kreier/solarmeter/aisvn/data/2020-05-26_battery_week.jpg

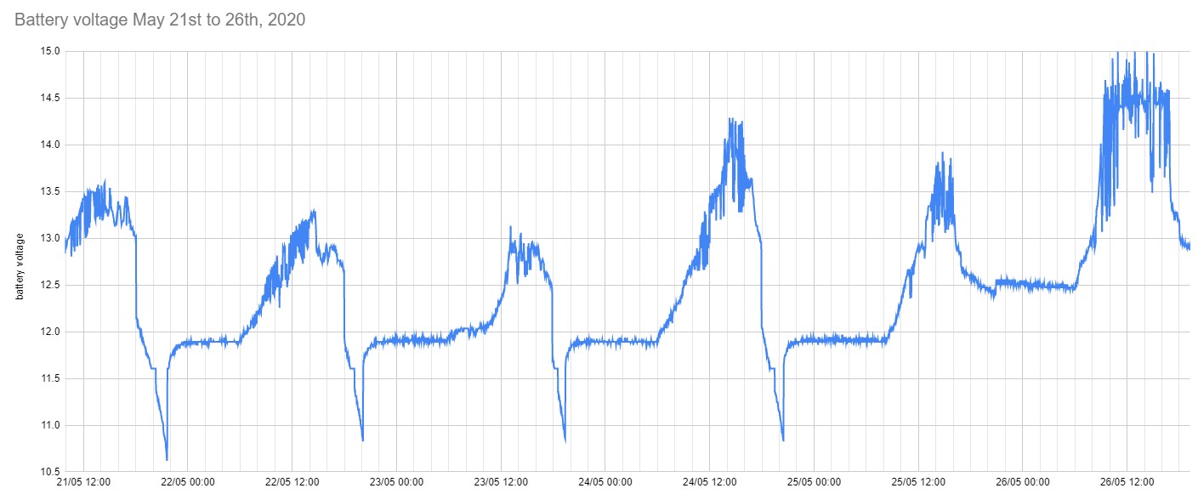
aisvn/data/2020-05-26_battery_week.jpg
