kreier/solarmeter/pic/2020-06-03_sketch_circuit.jpg

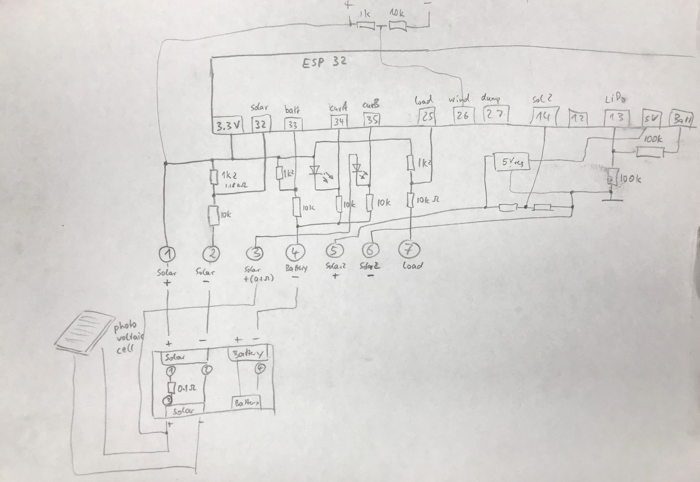
pic/2020-06-03_sketch_circuit.jpg
