kreier/solarmeter/software/calibration.xlsx

Sheet: 21
voltage | reading
0 | 0
100 | 0
222 | 0
334 | 26
640 | 210
787 | 298
1055 | 448
1454 | 689
1565 | 758
1635 | 803
2188 | 1136
2338 | 1241
2575 | 1365
2693 | 1440
2867 | 1535
3321 | 1815
3612 | 1982
4182 | 2331
4508 | 2529
4617 | 2609
5030 | 2896
5274 | 3038
5620 | 3409
5922 | 3771

Sheet: direct
voltage | reading
4 | 0
41 | 0
93 | 0
106 | 0
139 | 2
187 | 56
218 | 96
240 | 120
281 | 170
313 | 204
384 | 289
469 | 392
540 | 467
636 | 582
771 | 756
908 | 912
1095 | 1152
1241 | 1323
1345 | 1450
1572 | 1727
1650 | 1815
1767 | 1959
1961 | 2192
2069 | 2320
2252 | 2549
2414 | 2735
2571 | 2957
2610 | 3021
2707 | 3187
2827 | 3387
2877 | 3483
2936 | 3583
2965 | 3671
3040 | 3839
3107 | 3999
3224 | 4095
3298 | 4095
3158 | 4095
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
