kreier/solarmeter/(commit log)

2020-03-20 measure voltage with ESP32 setup
2020-04-01 relocated picture ESP32
2020-05-08 power consumption April 28th
2020-05-17 progress 2020-05-15
    [Solar_readings.xlsx, calibration.xlsx, pin34_input_value.xlsx]
2020-05-18 raw, solar and battery voltage
2020-05-22 shortened software sketch, removed LED indication
2020-05-28 drained battery, new MPPT charger
2020-05-31 measure the current of the solar panel
2020-06-09 all voltages calibrated, 100x multisample
2020-06-09 voltages calibrated, 100x multisample
2020-06-12 corrent and 5 voltages
2020-06-15 2020/06/15 v0.8 no more negative voltages
2020-06-16 2020/05/19 v0.2 now raw pin34, solar and battery voltage upload
2020-06-17 2020/06/17 v0.9 float voltages, power added, 0.85x
2020-06-17 2020/06/07 v0.4 Multisampling 100x removes noise but raises 25mV
    [SolarAISVN_4.ino]
2020-06-17 2020/06/08 v0.5 voltages calibrated, ADC2 WiFi hack reg_b
2020-06-18 general circuit June 5th, part for wind is still missing
2020-06-18 circuit from June 5th integrated
2020-06-18 20200618 v0.1 deep sleep active pin - proof of concept
    First working solution, measures and transmits data.
    Pin25 would go low on deep sleep, that's why additional lines 18, 47, 48 and finally 68 or 71
    gpio_num_t pin_LOAD = GPIO_NUM_25;
    rtc_gpio_init(pin_LOAD);
    rtc_gpio_set_direction(pin_LOAD,RTC_GPIO_MODE_OUTPUT_ONLY);
    rtc_gpio_set_level(pin_LOAD,0); // GPIO LOW
2020-06-18 new box with ESP32, voltage display and two shunts
2020-06-19 2020/06/19 v0.2 currents calibrated to same value
2020-06-22 2020/05/19 v0.2 pin34 raw, solar and battery
2020-06-22 2020/06/05 v0.3 included current over 0.122 resistor, weekend
    weekend test version, measures every minute
    included current measurement by voltage difference over 0.122 Ohm resistor
2020-06-22 2020/06/07 v0.4 multisampling 100x removes noise but raises 25 mV
    multisampling 100x removes noise, but increases measured voltages by 25 mV
    [SolarAISVN.ino, SolarAISVN_4.ino]
2020-06-22 2020/06/18 v0.1 active pin 25 during deep sleep - proof of concept
2020-06-22 2020/06/19 v0.2 current A and B calibrated, upload 120 seconds
2020-06-23 2020/06/22 hysteresis 12.8 an 12.2 V added
2020-06-23 2020/06/10 v0.6 voltages calibrated, included wind generator
2020-06-23 2020/06/15 v0.7 more voltage conversions, every 120 seconds
2020-06-23 2020/06/15 v0.8 no more negative voltages, offset solar2 fixed
    [SolarAISVN.ino, SolarAISVN_8.ino]
2020-06-23 2020/06/17 v0.9 voltages as floating point values, credentials.h added
2020-06-23 2020/05/17 v0.1 first automated solar voltage experiment
2020-06-23 2020/05/15 first measurements of analog values and calibration
    [pin34_input_value.xlsx]
2020-06-24 2020/06/23 v0.4 solar voltage and load indicator fixed
    [SolarAISVN2.ino]
2020-10-19 relocated by Arduino IDE
2020-10-26 calibrations from end of June 2020
    [calibration_2020-07-08.xlsx]
2020-10-29 relocated for Arduino IDE requirements
2020-10-29 definitions and calibrations in #define head
2020-10-30 relocated for Arduino IDE compability
