kreier/solarmeter/(notices)

Notices in the files:
README.md:
MIT license
